rafiul1232714/SLAM-Based-Autonomous-Car/README.md

# SLAM-Based-Autonomous-Car
Documenting all source code, hardware schematics, testing logs, and SLAM modules in an organized Git workflow (branching, commits, issue tracking) to ensure full version control and reproducibility throughout the ongoing autonomous vehicle project.
