rafiul1232714/SLAM-Based-Autonomous-Car/All_images/20251215_11h03m29s_grim.png

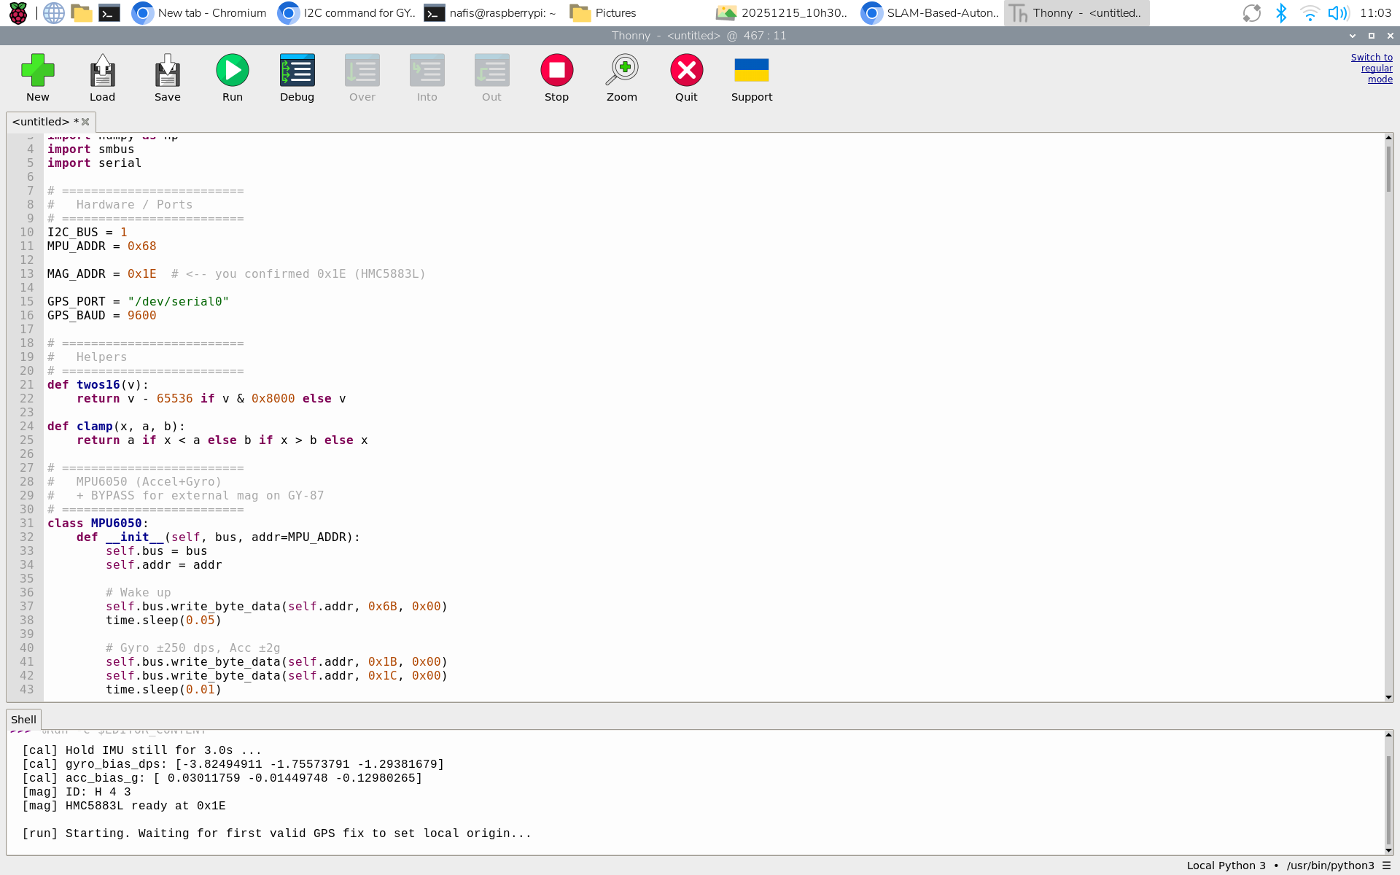
All_images/20251215_11h03m29s_grim.png
