rafiul1232714/SLAM-Based-Autonomous-Car/All_images/bottom.JPG

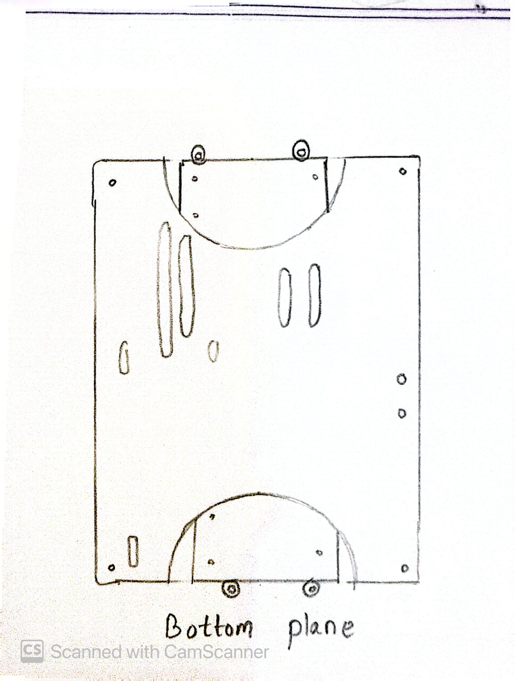
All_images/bottom.JPG
