rafiul1232714/SLAM-Based-Autonomous-Car/All_images/Design/fig_vehicle_front.jpg.jpeg

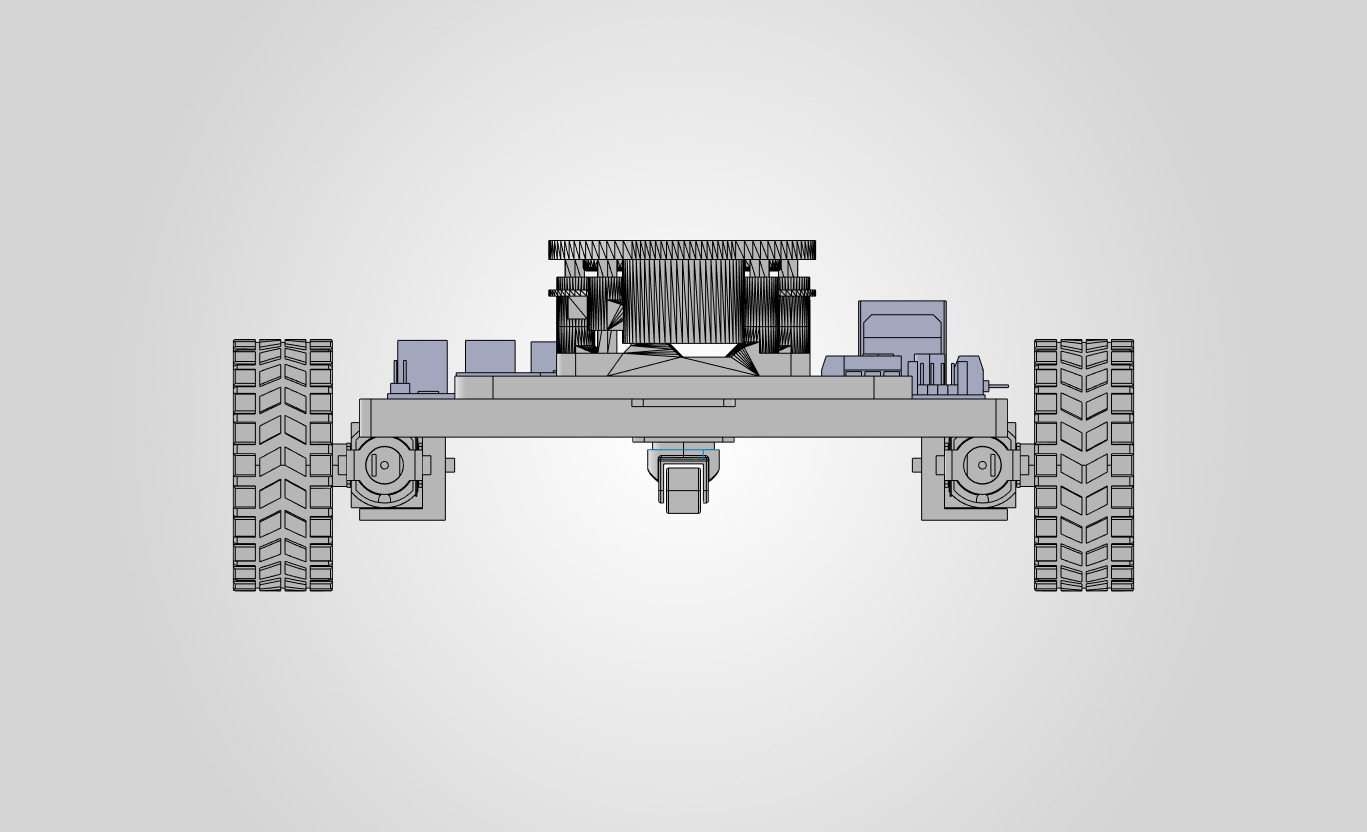
All_images/Design/fig_vehicle_front.jpg.jpeg
