rafiul1232714/SLAM-Based-Autonomous-Car/All_images/fusion_without_mag.png

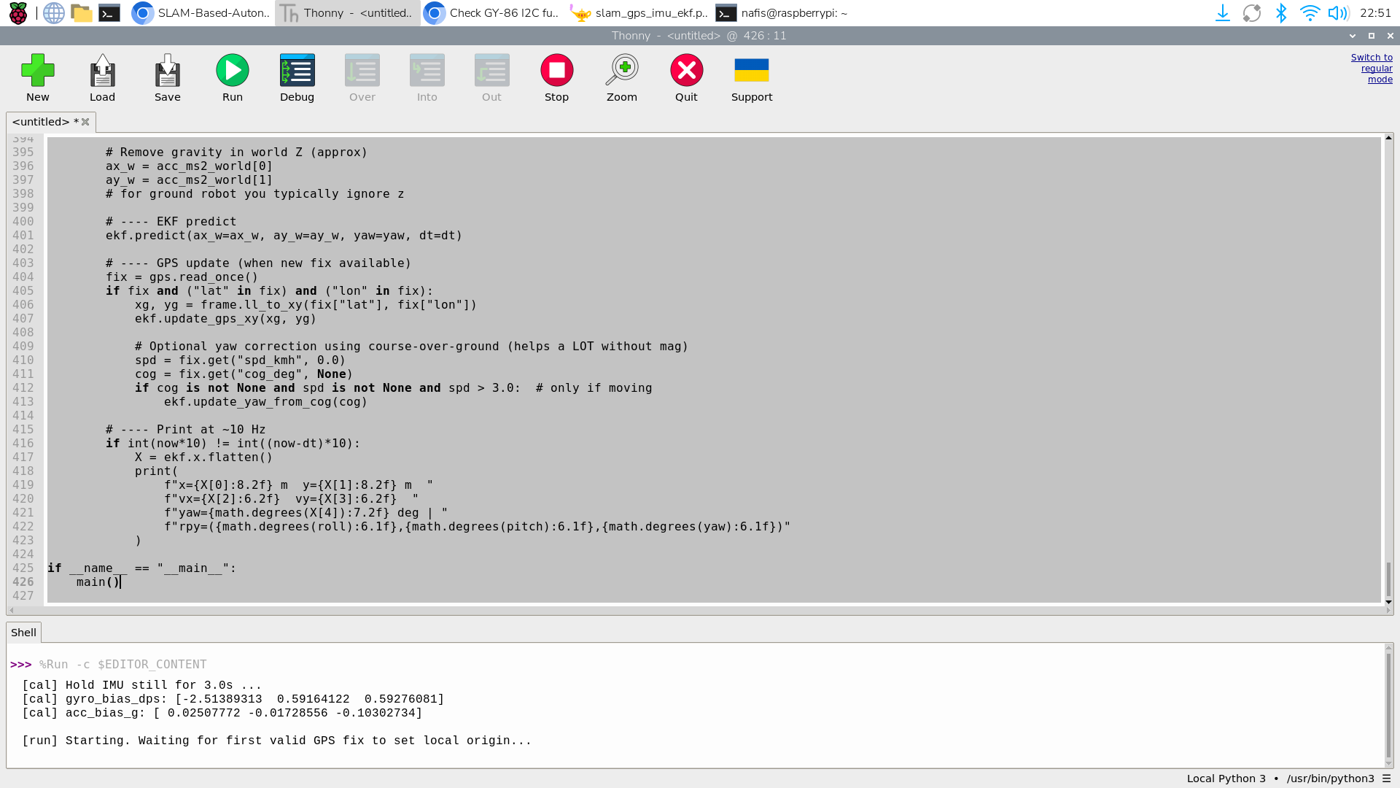
All_images/fusion_without_mag.png
