rafiul1232714/SLAM-Based-Autonomous-Car/All_images/lidar_imu_img.png

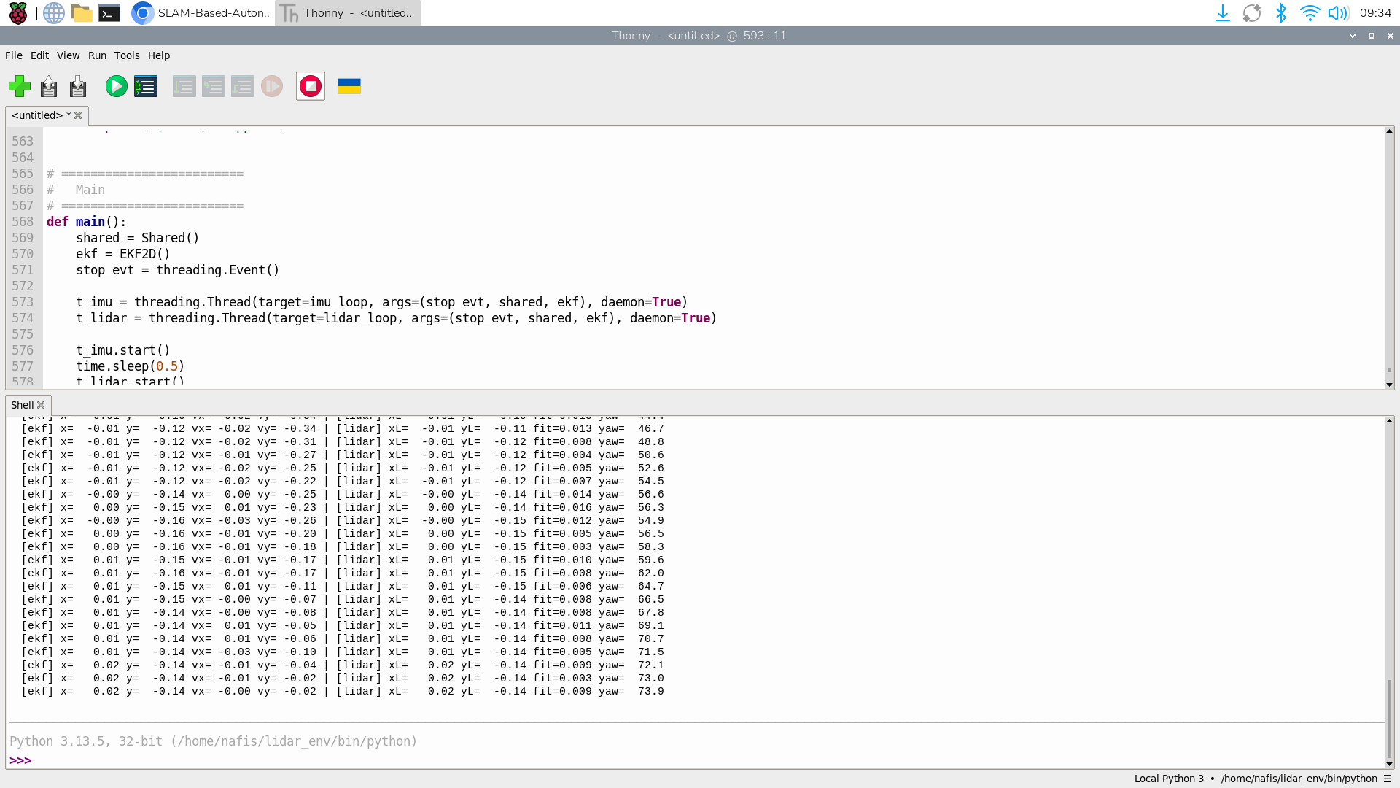
All_images/lidar_imu_img.png
