rafiul1232714/SLAM-Based-Autonomous-Car/All_images/motor Clamp.JPG

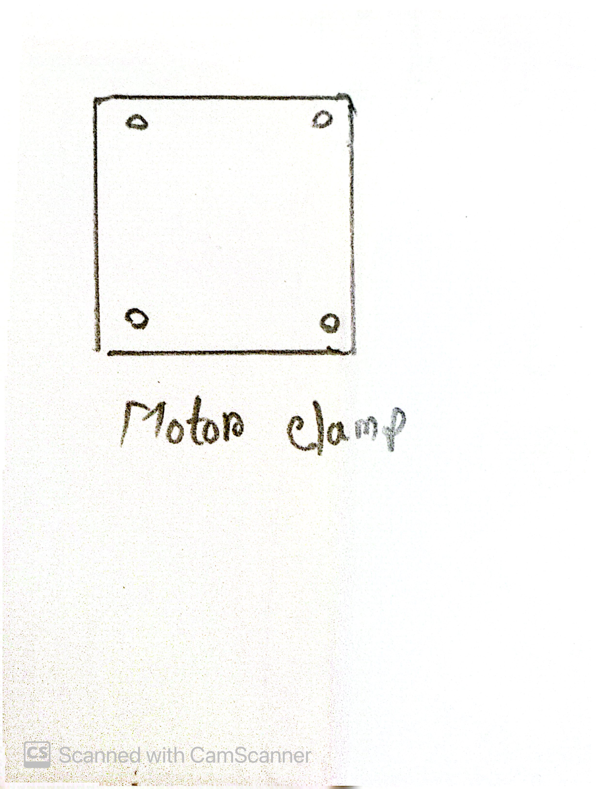
All_images/motor Clamp.JPG
