rafiul1232714/SLAM-Based-Autonomous-Car/All_images/top.JPG

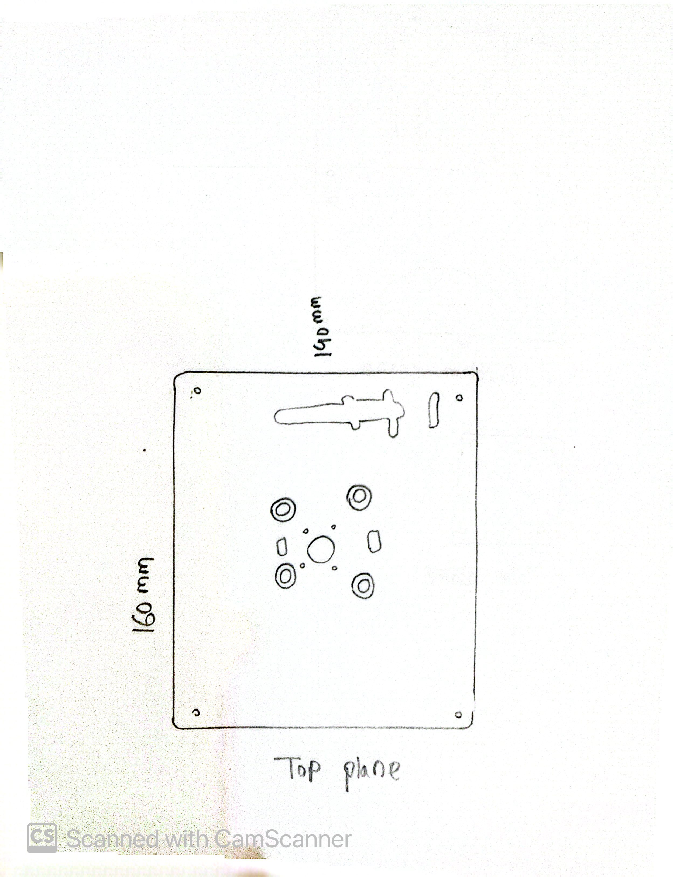
All_images/top.JPG
