rafiul1232714/SLAM-Based-Autonomous-Car/chassis.STL

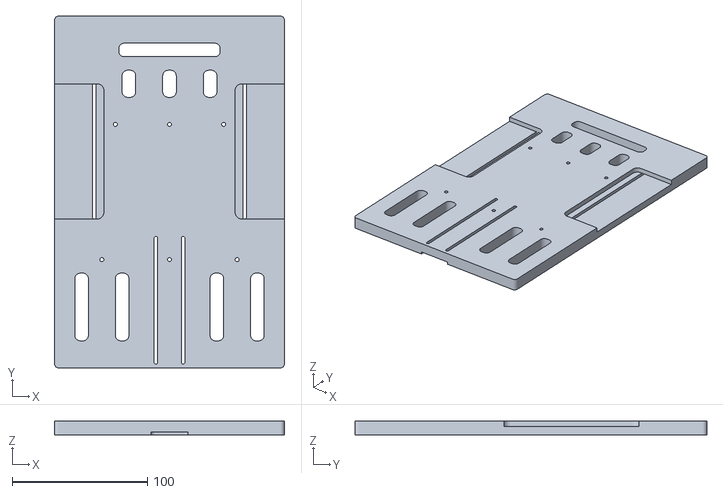
[picture p53: CAD file, 2026-02-09]
chassis.STL
170.0 x 260.0 x 10.0
