rafiul1232714/SLAM-Based-Autonomous-Car/Motor Mount2.STL

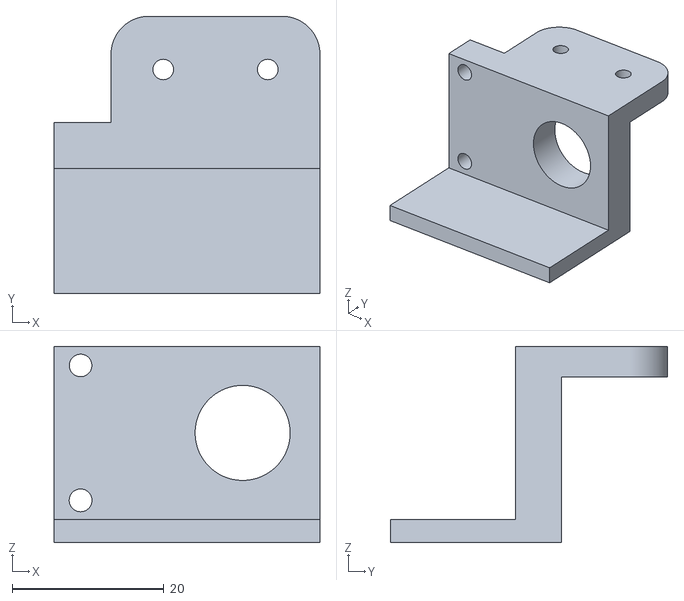
[picture p54: CAD file, 2026-02-09]
Motor Mount2.STL
35.0 x 36.5 x 25.8
