rafiul1232714/SLAM-Based-Autonomous-Car/LiDAR_Mount_v5 (1).STL

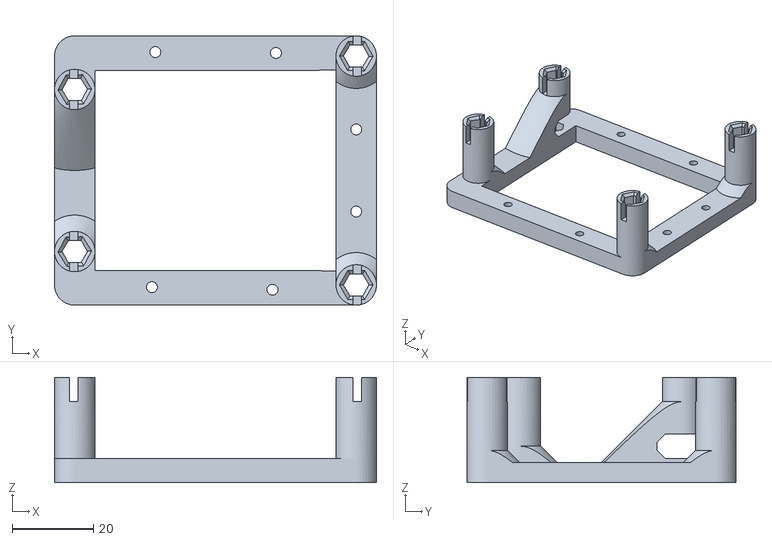
[picture p55: CAD file, 2026-02-09]
LiDAR_Mount_v5 (1).STL
79.5 x 66.5 x 26.0
