rafiul1232714/SLAM-Based-Autonomous-Car/upper floor.STL

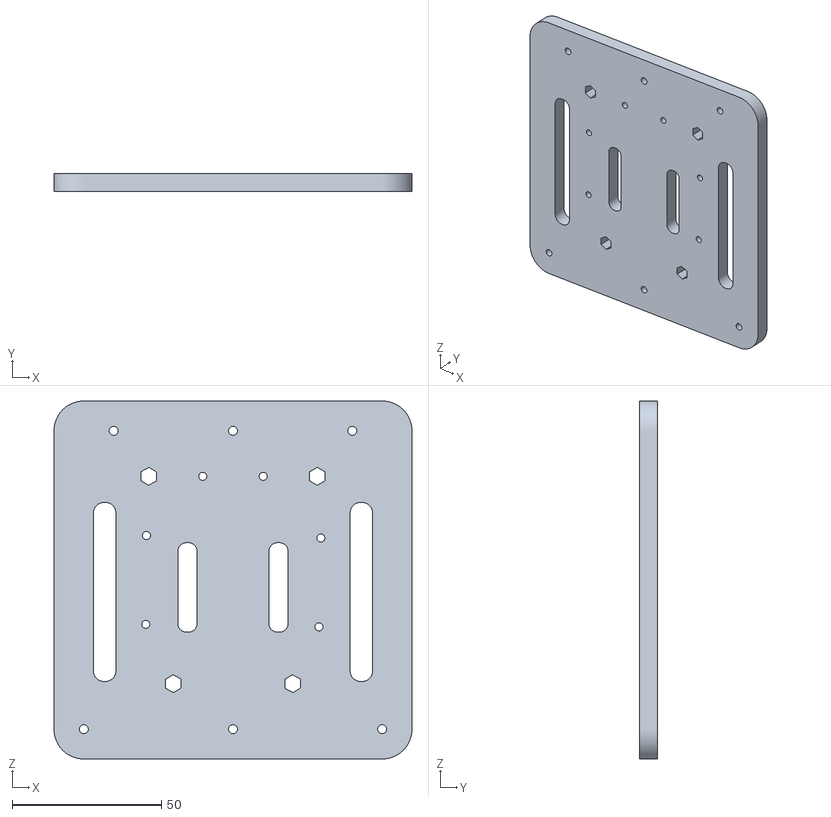
[picture p56: CAD file, 2026-02-09]
upper floor.STL
120.0 x 6.00 x 120.0
