rafiul1232714/SLAM-Based-Autonomous-Car/(list of files, cad)

Other CAD files:
Motor Mount1.STL
