rafiul1232714/SLAM-Based-Autonomous-Car/ROS2/rectangle_step2_EKF_LIDAR_CORRECTION_log - Copy.csv

time_s | phase | target_segment_mm | time_distance_mm | lidar_raw_mm | lidar_kalman_mm | lidar_segment_travel_mm | ekf_distance_mm | used_distance_mm | set_yaw_deg | actual_yaw_deg | pwm_left | pwm_right
2.001 | forward_1 | 300 | 0.01 | 1896.0 | 1894.56 | 0.0 | 0.0 | 0.01 | 0.0 | 0.0 | 50 | 60
2.023 | forward_1 | 300 | 1.76 | 1896.0 | 1894.56 | 0.0 | 0.94 | 1.76 | 0.0 | -0.02 | 50 | 60
2.045 | forward_1 | 300 | 3.52 | 1896.0 | 1894.56 | 0.0 | 1.8 | 3.52 | 0.0 | -0.02 | 50 | 60
2.067 | forward_1 | 300 | 5.26 | 1896.0 | 1894.56 | 0.0 | 2.57 | 5.26 | 0.0 | 0.35 | 50 | 60
2.088 | forward_1 | 300 | 7.01 | 1896.0 | 1894.56 | 0.0 | 3.27 | 3.27 | 0.0 | 0.53 | 50 | 60
2.11 | forward_1 | 300 | 8.75 | 1895.75 | 1894.88 | -0.32 | 3.81 | 3.81 | 0.0 | 0.3 | 50 | 60
2.131 | forward_1 | 300 | 10.45 | 1895.75 | 1894.88 | -0.32 | 4.27 | 4.27 | 0.0 | 0.42 | 50 | 60
2.153 | forward_1 | 300 | 12.17 | 1895.75 | 1894.88 | -0.32 | 4.67 | 4.67 | 0.0 | 0.37 | 50 | 60
2.175 | forward_1 | 300 | 13.92 | 1895.75 | 1894.88 | -0.32 | 5.04 | 5.04 | 0.0 | 0.23 | 50 | 60
2.196 | forward_1 | 300 | 15.65 | 1895.75 | 1894.88 | -0.32 | 5.33 | 5.33 | 0.0 | 0.13 | 50 | 60
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
