rafiul1232714/SLAM-Based-Autonomous-Car/(commit log)

2025-12-13 Create IMU_10_axis
2025-12-15 Create lidar
2025-12-20 Create lidar_imu_1
2025-12-20 Create lidar_imu_2
2025-12-20 Create lidar_imu_3
2025-12-22 Create motor_clamp
2026-03-03 Create motor_test
